parkourlrc/pcb-perc-sw--phyduino_pico2-cfc54fc3ee/docs/models/phyduino_pico2.step

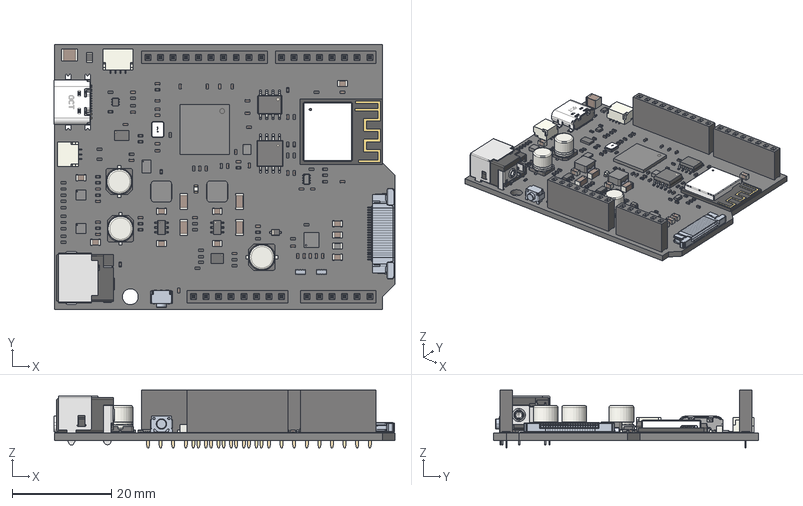
[picture p3: CAD file, 2026-10-20]
docs/models/phyduino_pico2.step
68.7 x 53.3 x 11.6 mm
R_0402_1005Metric x 54
C_0402_1005Metric x 45
PinSocket_1x08_P2.54mm_Vertical x 2
C_1206_3216Metric x 4
C_0805_2012Metric x 10
CAT_10-J x 2
SOIC-8_3.9x4.9mm_P1.27mm
Body001 (Mirror #1) x 2
JST_SH_SM04B-SRSS-TB_1x04-1MP_P1.00mm_Horizontal
Body_Solid1
Body001_Solid1
Array_Solid1 x 4
Array001_Solid2 x 3
Body002_Solid1
Array002_Solid1 x 4
Array003_Solid2 x 3
Body004_Solid1
RP2350B-QFN80_v12
TSOT-23-6 x 2
C_Elec_5x54 x 3
uid__2428
R0201_20210301.xtd x 3
L0201_20210301.xtd x 2
C0201_20210301.xtd x 10
ESP32-C6_QFN32_5X5_202306.xtd
XTAL3225_20210301.xtd
DFN1006.xtd
C0402_20210301.xtd
placementOutline_18
placementOutline_19
placementOutline_20
placementOutline_21
placementOutline_22
placementOutline_23
placementOutline_24
MINI-ANT-TYPE-D-H-top
MINI-ANT-TYPE-D-H-buttom
C3-MINI-solder_pad
ShieldBox_ESP32-C3-MINI-1_V1.0_20200901
SOT_666
C-1977067-1
PinSocket_1x06_P2.54mm_Vertical
AOTA-B201610S3R3-101-T
D_SOD-323
R_0805_2012Metric
L_0805_2012Metric
JST_SH_SM03B-SRSS-TB_1x03-1MP_P1.00mm_Horizontal
SOIC-8_5.3x5.3mm_P1.27mm
TPS55340QRTERQ1
TPS62933PDRLR
LED_0603_1608Metric
C_1210_3225Metric
DFN-8-1EP_3x2mm_P0.5mm_EP1.3x1.5mm
ABM8AIG
PinSocket_1x10_P2.54mm_Vertical
LM73100RPWR x 2
L_0402_1005Metric
F32Q_L
F32Q_M x 20
F32Q_R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
