parkourlrc/pcb-perc-sw--phyduino_pico2-cfc54fc3ee/phyduino_pico2.kicad_pcb

## KiCad design phyduino_pico2.kicad_pcb (2026-10-20)

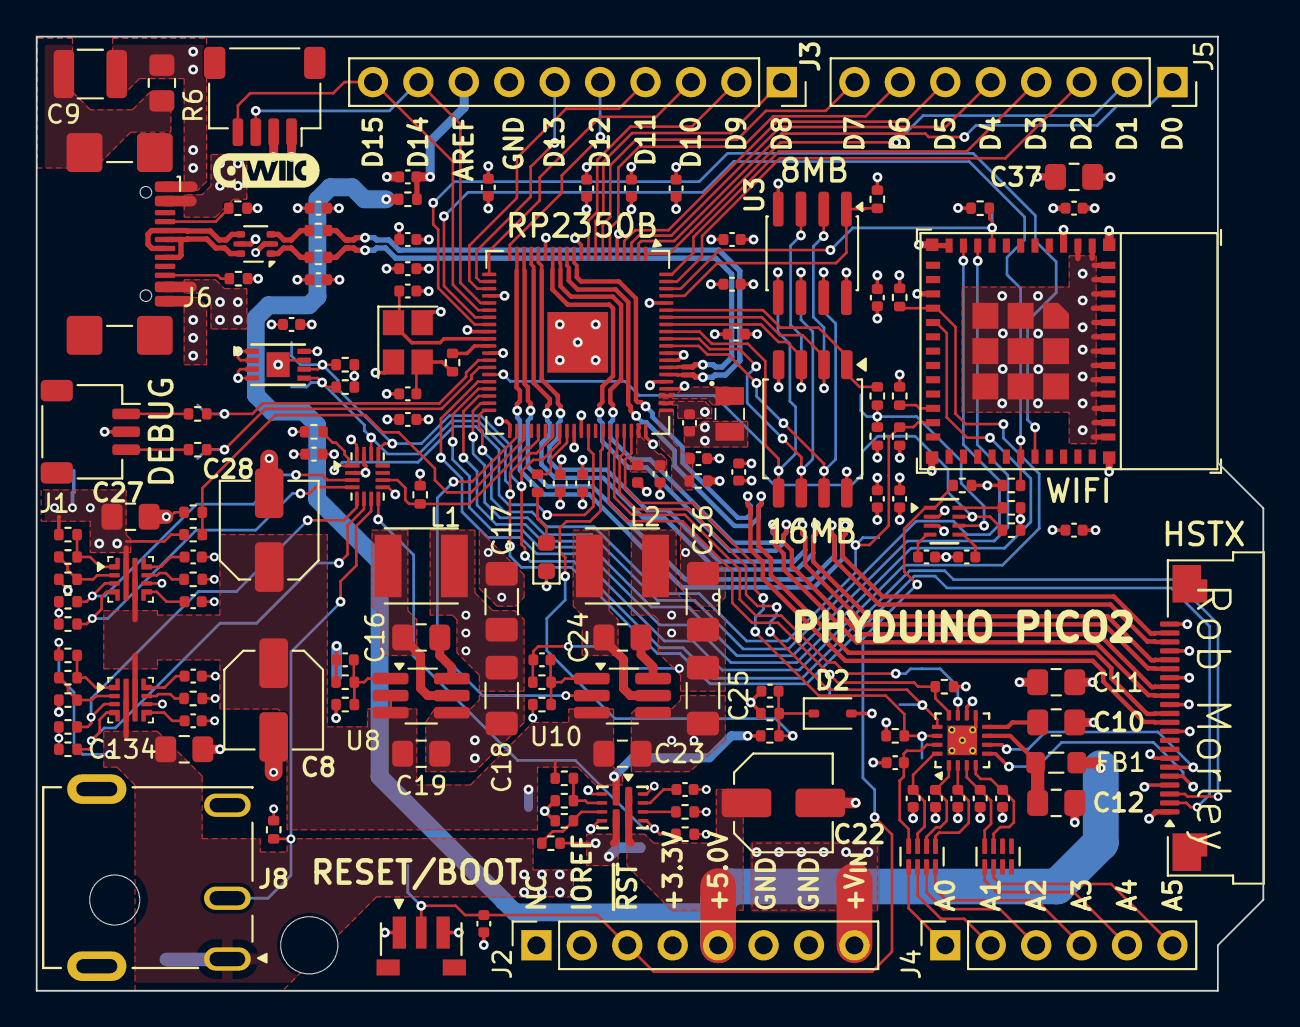
[picture p14: board phyduino_pico2.kicad_pcb from above]

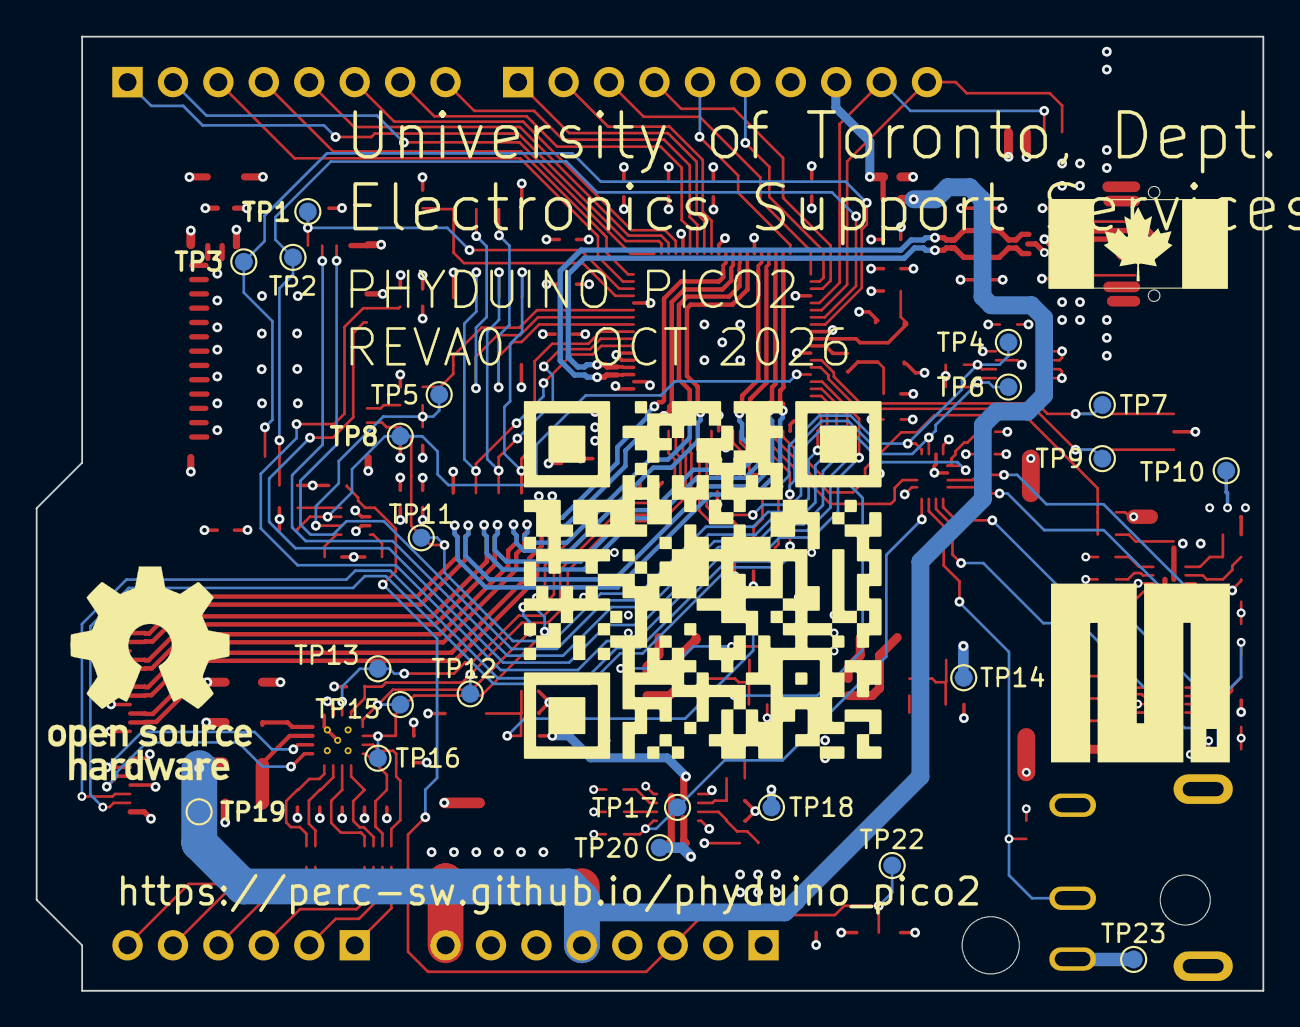
[picture p15: board phyduino_pico2.kicad_pcb from below]

Board: 4 copper layers, 68.6 x 53.3 mm, 175 parts (22 on the bottom side), 129 nets.

Parts:
C1, C6, C13, C20, C21, C26, C29, C34, C57, C110, C111, C117, C119, C125, C126, C127, C128, C129, C130, C131, C132, C133, C135, C137, C139: 0.1µF; C_0402_1005Metric
C2, C3, C4, C120: 4.7µF; C_0402_1005Metric
C5, C7: 100pF; C_0402_1005Metric
C8, C22, C28: 100µF; C_Elec_5x5.4
C9: 0.1µF; C_1210_3225Metric
C10, C11, C12, C134: 1µF; C_0805_2012Metric_Pad1.18x1.45mm_HandSolder
C14, C15: 27pF; C_0402_1005Metric
C16, C24: 0.1µF; C_0805_2012Metric_Pad1.18x1.45mm_HandSolder
C17, C18, C25, C36: 22µF; C_1206_3216Metric_Pad1.33x1.80mm_HandSolder
C19, C23, C27, C37: 10µF; C_0805_2012Metric_Pad1.18x1.45mm_HandSolder
C30, C31, C32, C33, C35, C38, C59: 1000pF; C_0402_1005Metric
C39: 1µF; C_0402_1005Metric
C58: 4700pF; C_0402_1005Metric
C136, C141: 1nF; C_0402_1005Metric
C140: 3300pF; C_0402_1005Metric
D1: GREEN; LED_0603_1608Metric
D2: 3.6V; D_SOD-323
FB1: 1kΩ@100MHz; L_0805_2012Metric_Pad1.05x1.20mm_HandSolder
FB100: MPZ1005S221HT000; L_0402_1005Metric
H2: MountingHole; MountingHole_3.2mm_M3
J1: SM03B-SRSS-TB; JST_SH_SM03B-SRSS-TB_1x03-1MP_P1.00mm_Horizontal
J2, J5: PPPC081LFBN-RC; PinSocket_1x08_P2.54mm_Vertical
J3: PPPC101LFBN-RC; PinSocket_1x10_P2.54mm_Vertical
J4: PPPC061LFBN-RC; PinSocket_1x06_P2.54mm_Vertical
J6: USB4110-GF-A; GCT-USBC-GCT_USB4110
J7: F32Q-1A7H1-11022; Amphenol_F32Q-1A7x1-11022_1x22-1MP_P0.5mm_Horizontal
J8: 54-00127; TENSILITY_54-00127
J9: SM04B-SRSS-TB; JST_SH_SM04B-SRSS-TB_1x04-1MP_P1.00mm_Horizontal
L1: 6.8µH; L_Bourns_SRP4021HMCT
L2: 10µH; L_Bourns_SRP4021HMCT
L3: 3.3µH; L_Abracon_AOTA-B201610S
R1, R2: 100Ω; R_0402_1005Metric
R3, R4, R5: 27Ω; R_0402_1005Metric
R6: 220kΩ; R_0805_2012Metric_Pad1.20x1.40mm_HandSolder
R13: 620Ω; R_0402_1005Metric
R20, R21, R22, R44, R45, R49, R51, R52, R53, R63, R64, R136, R137, R153, R157, R158, R162, R163, R164, R166: 10kΩ; R_0402_1005Metric
R42, R43, R47, R48, R50, R55, R61, R62, R65: 5.1kΩ; R_0402_1005Metric
R46, R139, R156: 1.1kΩ; R_0402_1005Metric
R56: 196kΩ; R_0402_1005Metric
R57: 62kΩ; R_0402_1005Metric
R58: 158kΩ; R_0402_1005Metric
R59: 30kΩ; R_0402_1005Metric
R134, R135, R138: 42.2kΩ; R_0402_1005Metric
R143, R149: 732kΩ; R_0402_1005Metric
R146, R155: 215kΩ; R_0402_1005Metric
R150, R154: 53.6kΩ; R_0402_1005Metric
R151: 22kΩ; R_0402_1005Metric
R152: 33kΩ; R_0402_1005Metric
R165: 100kΩ; R_0402_1005Metric
RN1, RN2: 1.0kΩ; RESCAV50P200X100X55-8N
SW1: 1977067-1; TE_1977067-1
TP1, TP2, TP3, TP4, TP5, TP6, TP7, TP8, TP9, TP10, TP11, TP12, TP13, TP14, TP15, TP16, TP17, TP18, TP19, TP20, TP22, TP23: TestPoint_Small; TestPoint_SameSky_CPG-47-TH-B
U1: RP2350B; QFN-80-1EP_10x10mm_P0.4mm_EP3.4x3.4mm
U2: AT25QF128A-SHB-T; SOIC-8_5.3x5.3mm_P1.27mm
U3: IS66WVS8M8FBLL-104NLI; SOIC-8_3.9x4.9mm_P1.27mm
U5: ADS7038IRTER; QFN50P300X300X80-17N
U6, U13: TPS259470ARPWR; Texas_Instruments_VQFN-HR-10
U7: AT24C64D-MAHM-T; DFN-8-1EP_3x2mm_P0.5mm_EP1.3x1.4mm
U8, U10: AP63301WU-7; TSOT-23-6_HandSoldering
U9: USBLC6-2P6; SOT-666
U11: ESP32-C6-MINI-1-H4; ESP32-C6-MINI-1
U14: FXL6408UMX; QFN40P260X180X55-16N
U15: TPS3424C11EF2ADRLR; SOT-5x3_DRL0008A_TEX
U108: TPS2121RUXR; VQFN-HR-12
Y1: ABM8G-12.000MHZ-18-D2Y-T; Crystal_SMD_Abracon_ABM8AIG-4Pin_3.2x2.5mm

Connections:
+1.1V: C2.1, C119.1, C120.1, C135.1, L3.1, U1.10 (DVDD), U1.32 (DVDD), U1.51 (DVDD), U1.65 (VREG_FB)
+3.3V: C1.1, C3.1, C5.1, C6.1, C11.1, C13.1, C17.1, C18.1, C20.1, C21.1, C26.1, C29.1, C34.1, C37.2, C110.1, C111.1, C125.1, C126.1, C127.1, C128.1, C129.1, C130.1, C133.1, C137.1, FB100.1, J2.2, J2.4, J7.1, J9.2, L1.2, R5.1, R20.1, R21.1, R22.1, R42.1, R43.1, R44.1, R45.1, R50.1, R51.1, R52.2, R55.1, R56.1, R61.1, R62.1, R63.1, R64.1, R153.2, R157.2, R158.2, R162.2, R163.2, R164.2, TP14.1 (1_1), U1.5 (IOVDD), U1.15 (IOVDD), U1.24 (IOVDD), U1.29 (IOVDD), U1.41 (IOVDD), U1.50 (IOVDD), U1.60 (IOVDD), U1.64 (VREG_VIN), U1.68 (USB_OTP_VDD), U1.69 (QSPI_IOVDD), U1.76 (IOVDD), U2.8 (VCC), U3.8 (VDD), U5.10 (DVDD), U7.8 (VCC), U9.5 (VBUS), U11.3 (3V3), U14.2 (VDDIO), U14.15 (VCC), U15.3 (VDD)
+3.3VA: C117.1, FB100.2, U1.59 (ADC_AVDD)
+5.0V: C22.1, FB1.1, J2.5, R65.1, TP19.1 (1_1), U108.1 (OUT), U108.8 (OUT)
+5.0VA: C12.1, FB1.2, U5.7 (AVDD)
+5.0V_DCDC: C7.1, C25.1, C36.1, L2.2, R58.1, R135.2, TP20.1 (1_1), U108.7 (IN1)
+VIN_REG: C8.1, C19.1, C23.1, C28.1, R138.2, R165.2, TP18.1 (1_1), U6.6 (OUT), U8.2 (EN), U8.3 (IN), U10.3 (IN), U13.6 (OUT), U108.2 (IN2)
+V_{EXTERNAL}: C134.1, J2.8, J8.1, R143.2, TP23.1 (1_1), U6.5 (IN)
+V_{USB}: C27.1, J6.A4 (VBUS), J6.A9 (VBUS), J6.B4 (VBUS), J6.B9 (VBUS), R149.2, R151.2, TP10.1 (1_1), U13.5 (IN)
/AREF: C39.1, J3.8, R65.2
/Microcontroller/A0: J4.1, RN1.1 (R1.1)
/Microcontroller/A1: J4.2, RN1.2 (R2.1)
/Microcontroller/A2: J4.3, RN1.3 (R3.1)
/Microcontroller/A3: J4.4, RN1.4 (R4.1)
/Microcontroller/A4: J4.5, RN2.1 (R1.1)
/Microcontroller/A5: J4.6, RN2.2 (R2.1)
/Microcontroller/ADC_MISO: R43.2, TP12.1 (1_1), U1.55 (GPIO44), U5.12 (SDO)
/Microcontroller/ADC_MOSI: R42.2, TP16.1 (1_1), U1.58 (GPIO47), U5.14 (SDI)
/Microcontroller/ADC_SCK: TP15.1 (1_1), U1.57 (GPIO46), U5.13 (SCLK)
/Microcontroller/ADC_nCS: TP13.1 (1_1), U1.56 (GPIO45), U5.11 (~CS)
/Microcontroller/BUILTIN_LED: R46.1, U1.49 (GPIO40)
/Microcontroller/D0: J5.1, U1.2 (GPIO5)
/Microcontroller/D1: J5.2, U1.1 (GPIO4)
/Microcontroller/D2: J5.3, U1.79 (GPIO2)
/Microcontroller/D3: J5.4, U1.80 (GPIO3)
/Microcontroller/D4: J5.5, U1.3 (GPIO6)
/Microcontroller/D5: J5.6, U1.4 (GPIO7)
/Microcontroller/D6: J5.7, U1.6 (GPIO8)
/Microcontroller/D7: J5.8, U1.7 (GPIO9)
/Microcontroller/D8: J3.1, U1.8 (GPIO10)
/Microcontroller/D9: J3.2, U1.9 (GPIO11)
/Microcontroller/D10: J3.3, U1.21 (GPIO21)
/Microcontroller/D11: J3.4, U1.23 (GPIO23)
/Microcontroller/D12: J3.5, U1.20 (GPIO20)
/Microcontroller/D13: J3.6, U1.22 (GPIO22)
/Microcontroller/D14: J3.9, J9.3, U1.25 (GPIO24)
/Microcontroller/D15: J3.10, J9.4, U1.26 (GPIO25)
/Microcontroller/DBIO_SWCLK: R1.2, TP7.1 (1_1), U1.33 (SWCLK)
/Microcontroller/DBIO_SWDIO: R2.2, TP9.1 (1_1), U1.34 (SWDIO)
/Microcontroller/DEBUG_SWCLK: J1.1, R1.1
/Microcontroller/DEBUG_SWDIO: J1.3, R2.1
/Microcontroller/EN_5V: U1.42 (GPIO33), U10.2 (EN)
/Microcontroller/EXT_AUXOFF: R158.1, U6.3 (AUXOFF), U14.5 (GPIO5)
/Microcontroller/EXT_~FLT: R157.1, U6.4 (~FLT), U14.6 (GPIO4)
/Microcontroller/EXT_~RESET: C57.1, J2.3, R22.2, SW1.2, TP22.1 (1_1), U15.1 (PB)
/Microcontroller/FLASH_CLK: U1.71 (QSPI_SCK), U2.6 (SCK), U3.6 (CLK)
/Microcontroller/FLASH_SD0: U1.72 (QSPI_SD0), U2.5 (I/O_{0}), U3.5 (SIO0)
/Microcontroller/FLASH_SD1: U1.74 (QSPI_SD1), U2.2 (I/O_{1}), U3.2 (SIO1)
/Microcontroller/FLASH_SD2: U1.73 (QSPI_SD2), U2.3 (IO_{2}), U3.3 (SIO2)
/Microcontroller/FLASH_SD3: U1.70 (QSPI_SD3), U2.7 (I/O_{3}), U3.7 (SIO3)
/Microcontroller/FLASH_~CS: R49.1, U1.75 (QSPI_~CS), U2.1 (~CS)
/Microcontroller/HSTX_LANE0_N: J7.12, U1.12 (GPIO13)
/Microcontroller/HSTX_LANE0_P: J7.11, U1.11 (GPIO12)
/Microcontroller/HSTX_LANE1_N: J7.15, U1.14 (GPIO15)
/Microcontroller/HSTX_LANE1_P: J7.14, U1.13 (GPIO14)
/Microcontroller/HSTX_LANE2_N: J7.18, U1.17 (GPIO17)
/Microcontroller/HSTX_LANE2_P: J7.17, U1.16 (GPIO16)
/Microcontroller/HSTX_LANE3_N: J7.21, U1.19 (GPIO19)
/Microcontroller/HSTX_LANE3_P: J7.20, U1.18 (GPIO18)
/Microcontroller/HS_GPIO0: J7.5, U5.5 (AIN6/GPIO6)
/Microcontroller/HS_GPIO1: J7.6, U5.6 (AIN7/GPIO7)
/Microcontroller/I2C1_SCL: J7.3, R62.2, TP4.1 (1_1), U1.48 (GPIO39), U7.6 (SCL), U14.13 (SCL)
/Microcontroller/I2C1_SDA: J7.2, R61.2, TP6.1 (1_1), U1.47 (GPIO38), U7.5 (SDA), U14.14 (SDA)
/Microcontroller/IO_EXP_~INT: R63.2, U1.52 (GPIO41), U14.1 (~INT)
/Microcontroller/IO_EXP_~RST: R64.2, U1.45 (GPIO36), U14.10 (~RST)
/Microcontroller/MCU_VREG_AVDD: C4.1, R5.2, U1.61 (VREG_AVDD)
/Microcontroller/MCU_VREG_LX: L3.2, U1.63 (VREG_LX)
/Microcontroller/MCU_XIN: C14.1, U1.30 (XIN), Y1.1
/Microcontroller/MCU_XOUT: R13.2, U1.31 (XOUT)
/Microcontroller/Memory/BOOT_LP_CAP: C58.1, U15.5 (LPT)
/Microcontroller/Memory/MCU_BOOT_SEL: R49.2, R52.1, TP5.1 (1_1), U15.6 (~RESET)
/Microcontroller/Memory/RESET_SP_CAP: C59.1, U15.4 (SPT)
/Microcontroller/PSW_STATUS: R153.1, TP17.1 (1_1), U14.8 (GPIO2), U108.9 (ST)
/Microcontroller/Peripherals/AIN0: C30.1, RN1.8 (R1.2), U5.15 (AIN0/GPIO0)
/Microcontroller/Peripherals/AIN1: C31.1, RN1.7 (R2.2), U5.16 (AIN1/GPIO1)
/Microcontroller/Peripherals/AIN2: C32.1, RN1.6 (R3.2), U5.1 (AIN2/GPIO2)
/Microcontroller/Peripherals/AIN3: C33.1, RN1.5 (R4.2), U5.2 (AIN3/GPIO3)
/Microcontroller/Peripherals/AIN4: C35.1, RN2.8 (R1.2), U5.3 (AIN4/GPIO4)
/Microcontroller/Peripherals/AIN5: C38.1, RN2.7 (R2.2), U5.4 (AIN5/GPIO5)
/Microcontroller/SYS_nRST: R20.2, TP8.1 (1_1), U1.35 (RUN), U15.7 (~INT)
/Microcontroller/USB_AUXOFF: R163.1, U13.3 (AUXOFF), U14.3 (GPIO7)
/Microcontroller/USB_D_N: R3.1, U9.3 (I/O2)
/Microcontroller/USB_D_P: R4.1, U9.1 (I/O1)
/Microcontroller/USB_IO_D_N: R3.2, U1.66 (USB_DM)
/Microcontroller/USB_IO_D_P: R4.2, U1.67 (USB_DP)
/Microcontroller/USB_~FLT: R162.1, U13.4 (~FLT), U14.4 (GPIO6)
/Microcontroller/VBUS_DETECT: R151.1, R152.2, U1.43 (GPIO34)
/Microcontroller/VIN_MONITOR: C141.1, D2.1 (K), R165.1, R166.2, U1.54 (GPIO43)
/Microcontroller/WIFI_BOOT1: R44.2, TP11.1 (1_1), U1.40 (GPIO32), U11.23 (IO9)
/Microcontroller/WIFI_DL_UART_RX: TP3.1 (1_1), U1.28 (GPIO27), U11.31 (TXD0)
/Microcontroller/WIFI_DL_UART_TX: R50.2, TP2.1 (1_1), U1.27 (GPIO26), U11.30 (RXD0)
/Microcontroller/WIFI_ENA: R53.1, TP1.1 (1_1), U1.78 (GPIO1), U11.8 (EN)
/Microcontroller/WIFI_UART_CTS: U1.38 (GPIO30), U11.9 (IO4)
/Microcontroller/WIFI_UART_RTS: U1.39 (GPIO31), U11.10 (IO5)
/Microcontroller/WIFI_UART_RX: U1.37 (GPIO29), U11.16 (IO7)
/Microcontroller/WIFI_UART_TX: R55.2, U1.36 (GPIO28), U11.15 (IO6)
/Microcontroller/XOUT: C15.1, R13.1, Y1.3
/Microcontroller/~EXT_PWR: J8.3, R164.1, U14.7 (GPIO3)
/Power/DCDC_3V3_BST: C16.1, U8.6 (BST)
/Power/DCDC_3V3_FB: C5.2, R56.2, R57.1, U8.1 (FB)
/Power/DCDC_3V3_SW: C16.2, L1.1, U8.5 (SW)
/Power/DCDC_5V0_BST: C24.1, U10.6 (BST)
/Power/DCDC_5V0_FB: C7.2, R58.2, R59.1, U10.1 (FB)
/Power/DCDC_5V0_SW: C24.2, L2.1, U10.5 (SW)
/Power/EXT_ILIM: R139.2, U6.9 (ILM)
/Power/EXT_ITIMER: C132.1, U6.10 (ITIMER)
/Power/EXT_OVLO: R146.1, R150.2, U6.2 (OVLO)
/Power/EXT_UVLO: R143.1, R146.2, U6.1 (EN/UVLO)
/Power/EXT_dVdt: C136.1, U6.7 (dVdt)
/Power/PMUX_LIM: R134.2, U108.10 (ILM)
/Power/PMUX_OV1: R135.1, R136.2, U108.5 (OV1)
/Power/PMUX_OV2: R137.2, R138.1, U108.4 (OV2)
/Power/PMUX_SS: C131.1, U108.11 (SS)
/Power/USB_ILIM: R156.2, U13.9 (ILM)
/Power/USB_ITIMER: C139.1, U13.10 (ITIMER)
/Power/USB_OVLO: R154.1, R155.2, U13.2 (OVLO)
/Power/USB_UVLO: R149.1, R154.2, U13.1 (EN/UVLO)
/Power/USB_dVdt: C140.1, U13.7 (dVdt)
/USB_CC1: J6.A5 (CC1), R48.1
/USB_CC2: J6.B5 (CC2), R47.1
/USB_COM_D_N: J6.A7 (D-), J6.B7 (D-), U9.4 (I/O2)
/USB_COM_D_P: J6.A6 (D+), J6.B6 (D+), U9.6 (I/O1)
/USB_COM_SHIELD: C9.1, J6.S2 (SH), R6.1
/Wireless Communication/WIFI_BOOT0: R45.2, U11.22 (IO8)
GND: C1.2, C2.2, C3.2, C4.2, C6.2, C8.2, C9.2, C10.2, C11.2, C12.2, C13.2, C14.2, C15.2, C17.2, C18.2, C19.2, C20.2, C21.2, C22.2, C23.2, C25.2, C26.2, C27.2, C28.2, C29.2, C30.2, C31.2, C32.2, C33.2, C34.2, C35.2, C36.2, C37.1, C38.2, C39.2, C57.2, C58.2, C59.2, C110.2, C111.2, C117.2, C119.2, C120.2, C125.2, C126.2, C127.2, C128.2, C129.2, C130.2, C131.2, C132.2, C133.2, C134.2, C135.2, C136.2, C137.2, C139.2, C140.2, C141.2, D1.1 (K), D2.2 (A), J1.2, J2.6, J2.7, J3.7, J6.A1 (GND), J6.A12 (GND), J6.B1 (GND), J6.B12 (GND), J7.4, J7.7, J7.10, J7.13, J7.16, J7.19, J7.22, J8.2, J9.1, R6.2, R47.2, R48.2, R53.2, R57.2, R59.2, R134.1, R136.1, R137.1, R139.1, R150.1, R152.1, R155.1, R156.1, R166.1, SW1.1, SW1.3 (1), U1.62 (VREG_PGND), U1.81 (GND), U2.4 (GND), U3.4 (VSS), U5.9 (GND), U5.17 (PAD), U6.8 (GND), U7.1 (A0), U7.2 (A1), U7.3 (A2), U7.4 (VSS), U7.7 (WP), U7.9 (EP), U8.4 (GND), U9.2 (GND), U10.4 (GND), U11.1 (GND), U11.2 (GND), U11.11 (GND), U11.14 (GND), U11.36 (GND), U11.37 (GND), U11.38 (GND), U11.39 (GND), U11.40 (GND), U11.41 (GND), U11.42 (GND), U11.43 (GND), U11.44 (GND), U11.45 (GND), U11.46 (GND), U11.47 (GND), U11.48 (GND), U11.49 (GND), U11.50 (GND), U11.51 (GND), U11.52 (GND), U11.53 (GND), U13.8 (GND), U14.9 (ADDR), U14.16 (GND), U15.2 (GND), U108.3 (CP2), U108.6 (PR1), U108.12 (GND), Y1.2, Y1.4
unnamed: D1.2 (A), R46.2
unnamed: C10.1, U5.8 (DECAP)
unnamed: R21.2, U15.8 (KILL)
PSRAM_CE#: R51.2, U1.77 (GPIO0), U3.1 (CE#)
