parkourlrc/pcb-perc-sw--phyduino_pico2-cfc54fc3ee/(commit log)

2026-10-20 Corrected soldermask error on U5:
    [phyduino_pico2-B_Cu.gbr, phyduino_pico2-B_Mask.gbr, phyduino_pico2-B_Paste.gbr, phyduino_pico2-B_Silkscreen.gbr, phyduino_pico2-Edge_Cuts.gbr, phyduino_pico2-F_Cu.gbr, phyduino_pico2-F_Mask.gbr, phyduino_pico2-F_Paste.gbr]
2026-10-20 Corrected soldermask error on U5: + add githook for regenerating output_manifest.json * regenerated project outputs.
    [phyduino_pico2-B_Cu.gbr, phyduino_pico2-B_Mask.gbr, phyduino_pico2-B_Paste.gbr, phyduino_pico2-B_Silkscreen.gbr, phyduino_pico2-Edge_Cuts.gbr, phyduino_pico2-F_Cu.gbr, phyduino_pico2-F_Mask.gbr, phyduino_pico2-F_Paste.gbr]
