parkourlrc/pcb-perc-sw--phyduino_pico2-cfc54fc3ee/(notices)

Notices in the files:
README.md:
Licence: GPL v3
